Pusparaj99op/HackTheHardware2.O/images/component.jpeg

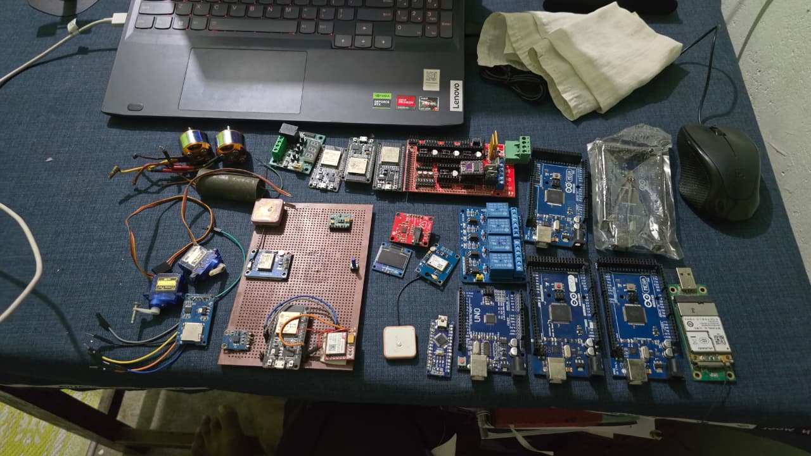
images/component.jpeg
