Pusparaj99op/HackTheHardware2.O/images/motors.jpeg

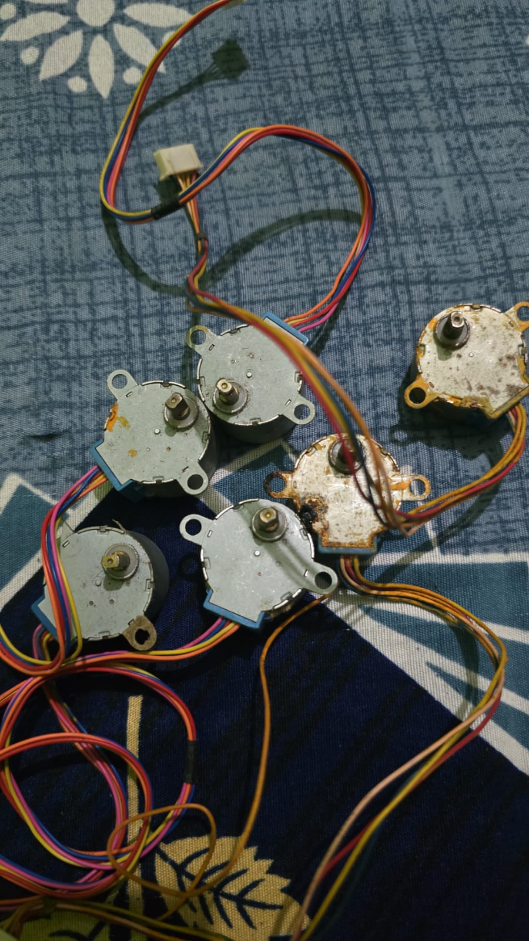
images/motors.jpeg
