Pusparaj99op/HackTheHardware2.O/VisionPilot.pptx

⚡ VISIONPILOT

AI-Assisted RC Car Controller

ESP32 · L298N · Servo · VL53L0X · MPU-6050 · GPS · Flutter APK

HackTheHardware 2.0 · 2026

## Slide 2

PROJECT OVERVIEW

What VisionPilot does

VisionPilot turns a cheap RC car into a wirelessly-controlled robot with real-time sensor feedback, safety interlocks, and a custom Android app — all built from scratch in 48 hours.

Hardware Stack
• ESP32 Dev Board (240 MHz, WiFi)
• L298N H-bridge motor driver
• Hobby servo for steering (GPIO13)
• VL53L0X ToF sensor (obstacle range)
• MPU-6050 IMU (accel + gyro)
• GY-NEO6MU2 GPS module
• 3x RAMPS bumper endstops
• 7.4V LiPo + 5V buck converter
• Samsung S24 running Flutter APK

Key Features
• WiFi UDP control at 20 Hz (< 50ms latency)
• Dual-joystick Android app (Flutter APK)
• Servo steering + DC motor speed control
• Hardware watchdog: stops on link drop
• Bumper interlock: locks fwd on collision
• Kill / Clear commands from the phone
• Live battery voltage + car state telemetry

## Slide 3

SYSTEM ARCHITECTURE

Communication and control flow

ANDROID APP
(Flutter)
Dual Joystick UI

ESP32 FIRMWARE
(Arduino)
UDP + State Machine

ACTUATORS
DC Motor (L298N)
Servo Steering

PHONE DISPLAY
Status · Battery
Bumper state

SENSORS
VL53L0X · MPU-6050
GPS · Bumpers

UDP port 4210 (D/K/C commands) · UDP port 4211 (T telemetry) · 20Hz drive loop · 300ms watchdog

## Slide 4

UDP CONTROL PROTOCOL

Text-based, stateless, sub-50ms latency

Commands (Phone → Car, port 4210)
• D,<seq>,<throttle>,<steer>
• seq — monotonic sequence number
• throttle — -100..+100 (neg=reverse)
• steer — -100..+100 (neg=left)
• K — KILL (immediate full stop)
• C — CLEAR (release kill/bumper lock)
• Sent at 20 Hz by Timer.periodic
• Out-of-order packets dropped (seq)

Telemetry (Car → Phone, port 4211)
• T,<seq>,<mask>,<mV>,<state>
• mask — bumper bits L=1 C=2 R=4
• mV — battery millivolts
• state — 0=OK 1=WD 2=BUMPER 3=KILL
• Sent every 100ms
• Dest: source IP of last D packet
• State machine:
• OK → normal drive
• WD → no packet >300ms → stop
• BUMPER → fwd blocked until reverse
• KILL → full stop until CLEAR

## Slide 5

ESP32 FIRMWARE

visionpilot_esp32.ino · Arduino Core 3.x

WiFi AP Mode
• ESP32 creates its OWN WiFi network
• SSID: VisionPilot Pass: vp123456
• IP always 192.168.4.1
• Phone joins car's WiFi directly
• No router / hotspot needed
• ensureWifi(): returns udpStarted in AP

Motor & Servo PWM
• ledcAttachChannel() — Arduino 3.x API
• Motor: ch0 · 1kHz · 10-bit · GPIO25
• Servo: ch2 · 50Hz · 16-bit · GPIO13
• Speed map: 35%-100% duty range
• Direction: IN1/IN2 digital H-bridge

Safety Interlocks
• Watchdog: no packet >300ms → stop
• Bumper lock: hit → fwd disabled
• Unlock: reverse off + C from phone
• Kill latch: K packet → full stop
• All states reported in telemetry

Sensor Reads
• Bumpers: digitalRead + PULLUP
• Battery: analogReadMilliVolts x3.128
• VL53L0X: I2C addr 0x29
• MPU-6050: I2C addr 0x68
• GPS: Serial2 9600 baud NMEA

## Slide 6

ANDROID CONTROL APP

Flutter · Dart · UDP · Dual Joystick · APK via ADB

car_socket.dart
• RawDatagramSocket (dart:io)
• Send to car 192.168.4.1:4210
• Listen port 4211 for telemetry
• Timer.periodic 20Hz drive loop
• sendDrive(throttle, steer)
• sendKill() / sendClear()
• Stream<Telemetry> broadcast

joystick_widget.dart
• GestureDetector + CustomPaint
• Bounded circular drag area
• 5% dead-zone at center
• Thumb snaps to center on release
• onChanged(dx, dy): -1.0..1.0
• Left Y-axis → throttle
• Right X-axis → steer

Build & Deploy
• Settings: IP + port persisted
• SharedPreferences storage
• flutter build apk --release
• adb install app-release.apk
•
• Permissions:
• INTERNET
• ACCESS_WIFI_STATE
• CHANGE_WIFI_MULTICAST_STATE

## Slide 7

WIRING SUMMARY

ESP32 GPIO pin assignments

GPIO

Connected To

Signal Type

Notes

GPIO 25

GPIO 26

L298N ENA

L298N IN1

PWM 1kHz

Digital OUT

Motor speed (remove ENA jumper!)

Motor direction A

GPIO 27

L298N IN2

Digital OUT

Motor direction B

GPIO 13

GPIO 32

Servo SIG

Bumper LEFT

PWM 50Hz

INPUT_PULLUP

Steering 1100-1900µs center 1500

Active LOW when pressed

GPIO 33

GPIO 14

Bumper CENTER

Bumper RIGHT

INPUT_PULLUP

INPUT_PULLUP

Active LOW when pressed

Active LOW when pressed

GPIO 35

Battery ADC

ADC1_CH7

100kΩ+47kΩ divider ×3.128

GPIO 21

GPIO 22

SDA

SCL

I²C

I²C

VL53L0X(0x29)+MPU-6050(0x68) shared

Shared I²C bus

GPIO 16

GPS TX→RX

UART2 RX

9600 baud NMEA

GPIO 17

GPIO 2

GPS RX←TX

Built-in LED

UART2 TX

Digital OUT

9600 baud

Solid=OK fast-blink=no link

## Slide 8

DEMO RESULTS

What we built and tested successfully

Critical Bug Fixed
• AP mode: WiFi.status() never returns
• WL_CONNECTED (ESP32 IS the AP)
• ensureWifi() always returned false
• Fix: #if USE_AP_MODE return udpStarted
• After reflash: app showed OK instantly

Build Challenges Solved
• USE_AP_MODE (SDK enum conflict fix)
• ESP32 bootloader: manual BOOT+EN
• Flash baud 921600→115200 for stability
• ADB sideload without manual transfer

Successfully Demonstrated
• ESP32 flashed via arduino-cli (headless)
• WiFi AP 'VisionPilot' visible on phone
• Samsung S24 joined car's WiFi network
• Flutter APK installed via ADB
• App shows green 'OK' status
• Live battery voltage in app UI
• Left joystick → DC motor fwd/rev
• Right joystick → servo steering
• KILL button → immediate car stop
• CLEAR resumes normal drive
• Bumper interlock working correctly
• Watchdog stops car on app close

## Slide 9

NEXT STEPS

Future development roadmap

App Enhancements
• Integrate into main codebase
• OTA firmware update from app
• GPS live map on phone screen
• Record and replay drive paths
• Autonomous follow mode UI
• Obstacle avoidance overlay

Firmware Features
• VL53L0X obstacle avoidance
• MPU-6050 traction/stability
• GPS waypoint following
• PID speed controller
• Explore and replay brain
• ESP32-CAM video stream

Infrastructure
• Custom PCB for clean wiring
• 3D printed sensor mounts
• LiPo charge indicator
• GitHub Actions CI build
• Unit tests for state machine
• Docker dev environment

## Slide 10

THANK YOU

VisionPilot — Built at HackTheHardware 2.0

ESP32 · Flutter · UDP · L298N · Servo · VL53L0X · MPU-6050 · GPS

Questions?
