Pusparaj99op/HackTheHardware2.O/DEMO/demo-image/image.png

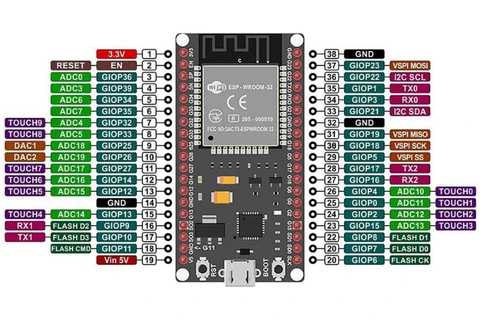
DEMO/demo-image/image.png
