Pusparaj99op/HackTheHardware2.O/DEMO/demo-image/WhatsApp Image 2026-09-28 at 10.06.45 PM.jpeg

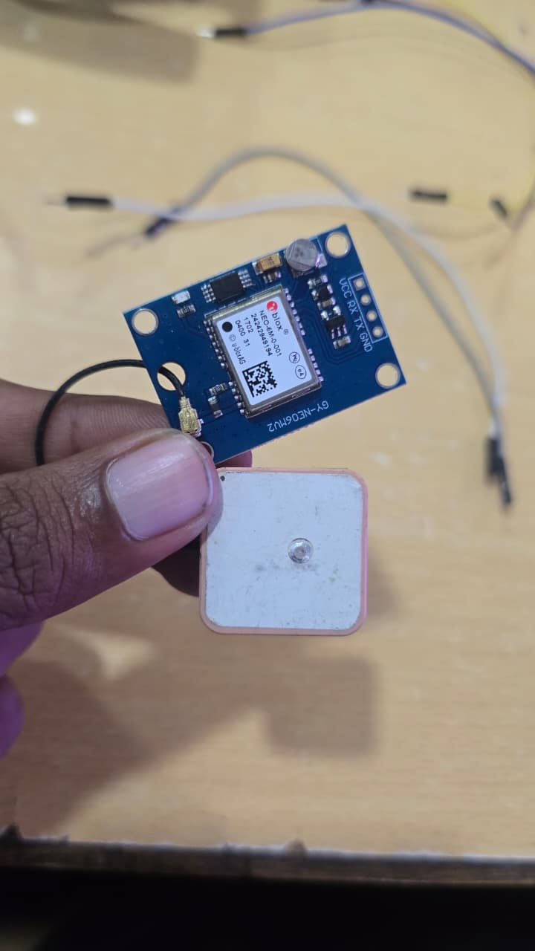
DEMO/demo-image/WhatsApp Image 2026-09-28 at 10.06.45 PM.jpeg
