Pusparaj99op/HackTheHardware2.O/DEMO/demo-image/WhatsApp Image 2026-09-28 at 10.08.13 PM (1).jpeg

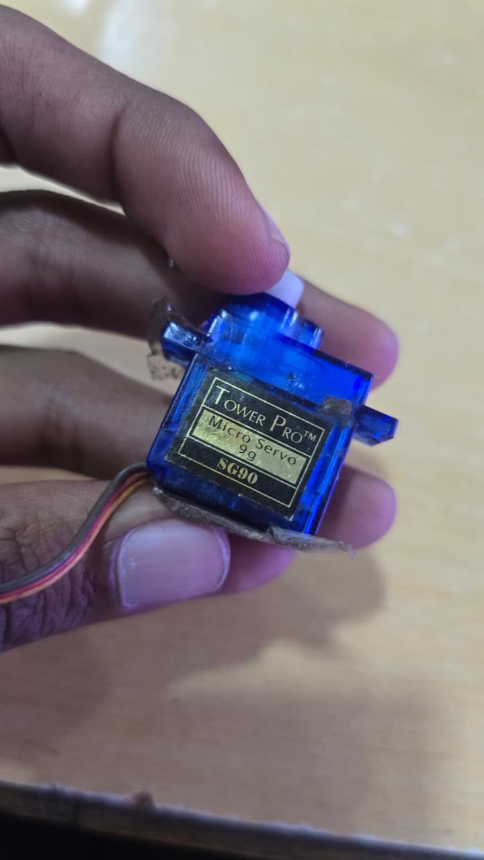
DEMO/demo-image/WhatsApp Image 2026-09-28 at 10.08.13 PM (1).jpeg
