Pusparaj99op/HackTheHardware2.O/images/chassy.jpeg

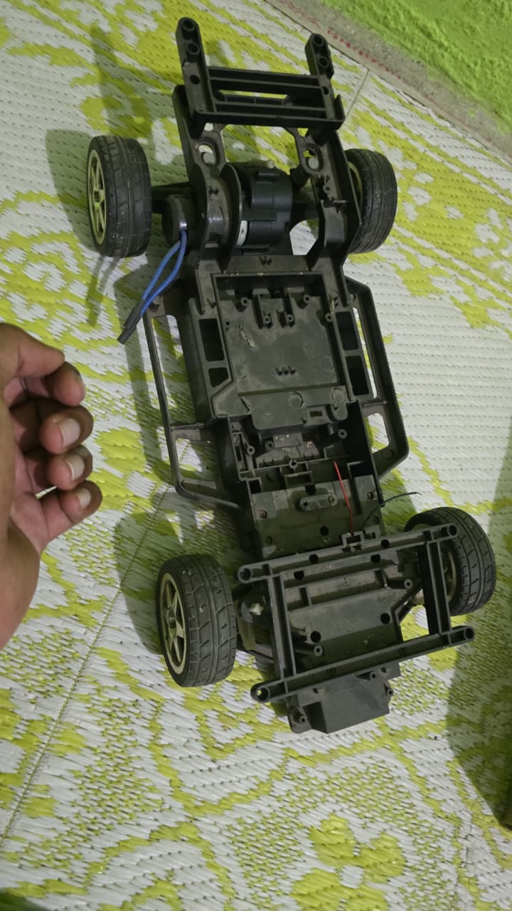
images/chassy.jpeg
