Pusparaj99op/HackTheHardware2.O/images/remote.jpeg

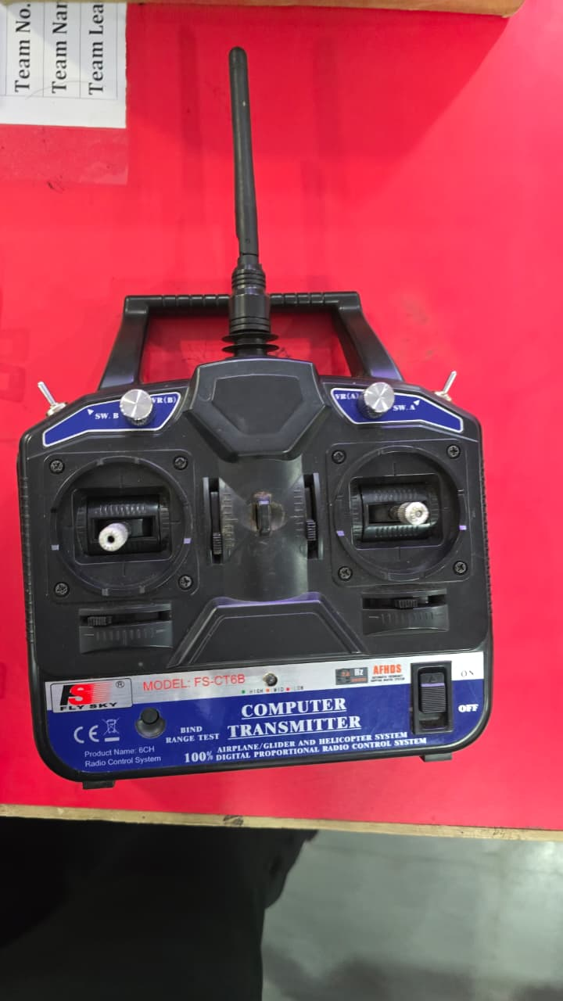
images/remote.jpeg
