Pusparaj99op/HackTheHardware2.O/(commit log)

2026-09-28 feat: M0 car link - ESP32 firmware, UDP protocol, safety arbiter
    - ESP32 sketch: L298N + servo drive, 300ms watchdog, bumper lock, kill latch
    - Laptop: protocol encode/decode, safety arbiter, async UDP CarLink
    - Tools: terminal drive_test and fake_car simulator
    - Design spec in docs/superpowers/specs
2026-09-28 feat: driving brains - follow, explore, replay, handheld, odometry, path memory
    - FOLLOW: YOLO track lock, tap-to-pick, bbox-height distance, coast then stop
    - EXPLORE: depth column openness steering, reverse-away recovery
    - REPLAY: pure-pursuit on recorded track, pauses for obstacles
    - HANDHELD: ArUco car pose + potential field with sideways avoidance
    - Odometry: phone gyro projected on gravity + speed model gated by optical flow
    - Path memory: immutable tracks, sanitized JSON save/load
    - 73 unit tests
2026-09-28 feat: M1+M2 server, phone streamer, dashboard, vision worker
    - FastAPI app: /phone + dashboard pages, WebSockets, 20 Hz control task
    - Control loop wiring behaviours, safety arbiter, odometry, path memory
    - Validated JSON commands at the network boundary
    - Vision worker thread: YOLO11+ByteTrack, Depth-Anything-V2, ArUco, optical flow
    - Phone page: camera + gyro streaming, AI box overlay, tap-to-track
    - Dashboard: live AI view, ARM/KILL (Space), modes, map, manual WASD/pad
    - Self-signed HTTPS cert for Android Chrome camera access
2026-09-28 docs: README setup checklist, demo script; tools for marker, speed calibration
2026-09-28 fix: stop manual drive on focus loss; drop out-of-order UDP drive packets
    Code review HIGH: a drag on the dashboard pad kept sending throttle if the
    window lost focus without pointerup. Release pad on blur, lostpointercapture
    and hidden tab. Firmware ignores stale seq while the link is live.
    [visionpilot_esp32.ino]
2026-09-29 feat: laptop vision brain hands off with phone app; firmware multi-peer
    - Firmware: telemetry to up to 2 peers (app + laptop), P ping, per-peer seq
    - Laptop is silent until engaged (VISION in the app), pings car for telemetry
    - engage/release/kill semantics; joystick override resumes vision after 1 s
    - New ASSIST mode: manual driving with vision auto-brake
    - UDP discovery responder (VP? -> VPL,<port>,<tls>) for the phone app
    - Default car IP 192.168.4.1 (ESP32 AP); prefetch_models tool + GPU benchmark
    - Drop deprecated YOLO half flag (per-frame warning spam)
2026-09-29 feat: VISION button in the phone controller app
    - App: VISION toggle hands the car to the laptop AI (app pauses to pings)
    - Live annotated AI video between the joysticks with tap-to-target
    - Mode chips (Assist/Follow/Explore/Replay/Hand-held) + class picker
    - Joystick touch = manual override; KILL goes direct to the car + laptop
    - Laptop link loss falls back to direct joystick control
    - Settings: laptop IP + Find laptop (UDP discovery)
    - Laptop: depth model loads from local cache (AP has no internet)
    - 14 Flutter tests, README vision-mode guide, design addendum
2026-09-29 feat: phone-as-camera roles and compact top bar in the app
    - Roles: Controller / Camera / Controller + Camera (Settings)
    - Camera streams NV21->JPEG (~10 fps) + gyro over /ws/phone
    - Local preview with AI boxes; tap-to-target
    - Thin 40 px top bar
    - Laptop: newest phone is the active camera; ?frames=0 opt-out
2026-09-29 feat: portrait Camera role with lens switch, upright/mirrored frames, hardening
    - Orientation locked per role (Camera portrait, others landscape)
    - One-pass NV21 rotate 0/90/180/270 + mirror; front lens matches selfie preview
    - Switch camera (saved), lifecycle pause/resume, serialized camera ops
    - Permission error view, encode errors logged, car socket restarts on IP/port change
    - App label VisionPilot, README with roles/setup/demo checklist
